RonnyFalconeri/night-light-uino/src/tests/animation/animation.ino

/*
    Running light effect

    inspired from this page: https://www.instructables.com/LED-Row-Fade-Arduino/
    
*/

int led1 = 3;
int led2 = 5;
int led3 = 6;
int led4 = 9;
int led5 = 10;
int led6 = 11;

int del = 100;

void setup(){
  Serial.begin(9600);

  pinMode(led1, OUTPUT);
  pinMode(led2, OUTPUT);  
  pinMode(led3, OUTPUT);  
  pinMode(led4, OUTPUT);  
  pinMode(led5, OUTPUT);
  pinMode(led6, OUTPUT);
}

void loop(){
  int potVal = analogRead(A0);

  int scale = map(potVal, 0, 1023, 0, 6);

  Serial.print("Analog: ");
  Serial.println(potVal);

  Serial.print("Scale: ");
  Serial.println(scale);

  
  if (scale==0) {
    digitalWrite(led1, LOW);
    digitalWrite(led2, LOW);
    digitalWrite(led3, LOW);
    digitalWrite(led4, LOW);
    digitalWrite(led5, LOW);
    digitalWrite(led6, LOW);
  }

  if (scale > 0) {
    digitalWrite(led1, HIGH);
    digitalWrite(led2, LOW);
    digitalWrite(led3, LOW);
    digitalWrite(led4, LOW);
    digitalWrite(led5, LOW);
    digitalWrite(led6, LOW);
  }

  if (scale > 1) {
    digitalWrite(led1, HIGH);
    digitalWrite(led2, HIGH);
    digitalWrite(led3, LOW);
    digitalWrite(led4, LOW);
    digitalWrite(led5, LOW);
    digitalWrite(led6, LOW);
  }

  if (scale > 2) {
    digitalWrite(led1, HIGH);
    digitalWrite(led2, HIGH);
    digitalWrite(led3, HIGH);
    digitalWrite(led4, LOW);
    digitalWrite(led5, LOW);
    digitalWrite(led6, LOW);
  }

  if (scale > 3) {
    digitalWrite(led1, HIGH);
    digitalWrite(led2, HIGH);
    digitalWrite(led3, HIGH);
    digitalWrite(led4, HIGH);
    digitalWrite(led5, LOW);
    digitalWrite(led6, LOW);
  }

  if (scale > 4) {
    digitalWrite(led1, HIGH);
    digitalWrite(led2, HIGH);
    digitalWrite(led3, HIGH);
    digitalWrite(led4, HIGH);
    digitalWrite(led5, HIGH);
    digitalWrite(led6, LOW);
  }

  if (scale > 5) {
    digitalWrite(led1, HIGH);
    digitalWrite(led2, HIGH);
    digitalWrite(led3, HIGH);
    digitalWrite(led4, HIGH);
    digitalWrite(led5, HIGH);
    digitalWrite(led6, HIGH);
  }

  delay(del);
}
